HanjingLaura/hutong-moles/web/characters/kay.png

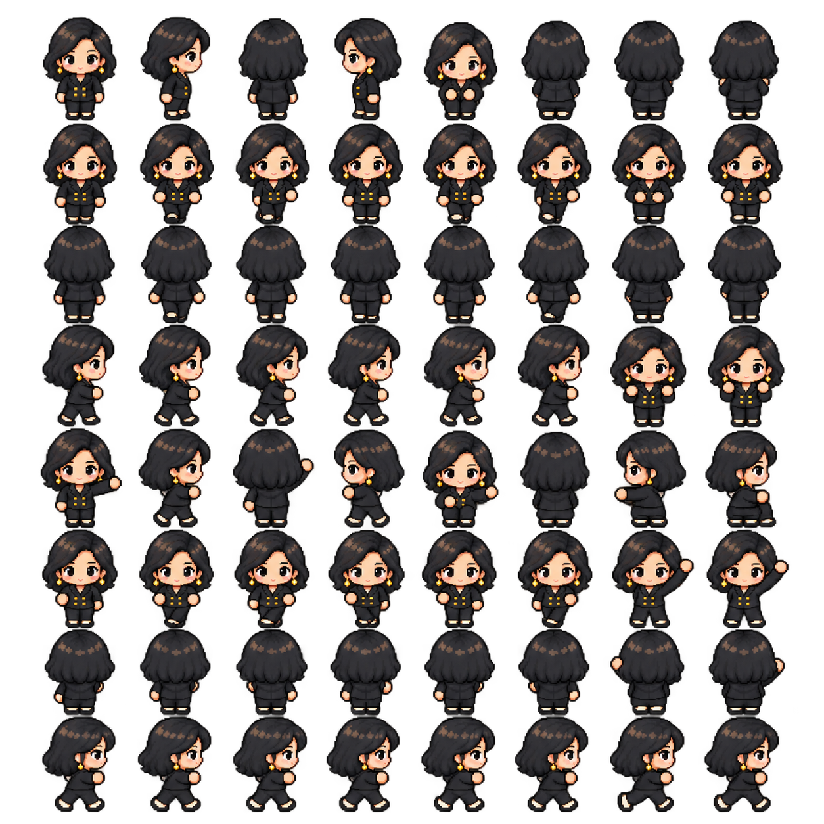
web/characters/kay.png
