HanjingLaura/hutong-moles/web/characters/cora.png

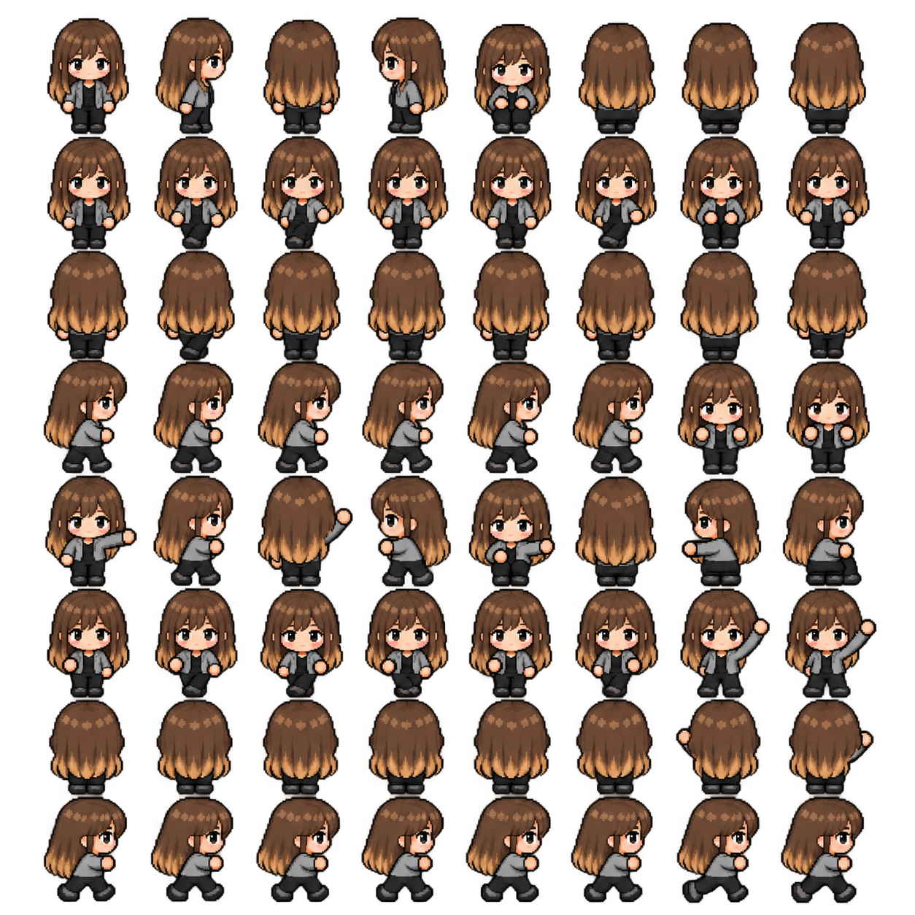
web/characters/cora.png
