HanjingLaura/hutong-moles/LEARNING.md

# Hutong Moles 学习总结

2026-10-04 完成。一块 Arduino Uno、6 颗 LED、6 个按键，加一个网页，做成了实体打地鼠：网页决定哪只地鼠冒头，对应的灯亮，按下对应按键就算打中。

## 这个项目做了什么

- **硬件**：Uno 只干两件事：按网页的命令点灯，按键被按下时报告给网页。
- **软件**：游戏规则（出地鼠、计时、计分）全在网页里，通过 USB 串口（Web Serial）和 Uno 通信。
- **分工的好处**：改玩法只要改网页，不用重新烧录；Uno 的代码很短，出问题容易排查。

## 学到的硬件知识

### 1. 面包板内部怎么连的

- 中间区域每一条 **5 孔竖排是连通的**，中间凹槽把上下两半隔开。
- 两边的长条是电源轨，红色（+）和蓝色（−）各自整条连通；有些长面包板的电源轨在中间断开。
- 规律：**插在同一条竖排里的脚，等于用导线连在一起了。** 这次两个坑都是因为这一条。

### 2. LED 电路

- 接法：引脚 → 220Ω 电阻 → 长脚（正极），短脚（负极）→ GND。
- 电阻用来限流，不加的话 LED 和引脚都可能烧坏。
- LED 有方向，接反就不亮（不会坏，翻过来就好）。

### 3. 6×6 轻触按键

- 四只脚两两常通，按下时两对才连起来。
- **取对角的两只脚** 最保险，无论怎么转都是按下才通。
- 按键横跨中间凹槽插，两边的脚就落在不同的竖排里。
- 要压到底，没插紧会接触不良。

### 4. 内部上拉（INPUT_PULLUP）

- 引脚设成 `INPUT_PULLUP` 后，芯片内部有一个电阻把它拉到高电平，不按读 HIGH（模拟读数约 1023）。
- 按下时按键把引脚接到 GND，读到 LOW（约 0）。
- 所以按键 **不需要外接电阻**，只要两根线：一根到 A 口，一根到地。地线可以共用同一条蓝色地轨。

### 5. A0–A5 也能当普通数字口用

- 模拟口可以 `digitalRead`，也可以 `analogRead` 看 0–1023 的具体数值。排查时用数值比只看 HIGH/LOW 信息多得多。

### 6. 去抖动

- 按键按下的一瞬间会抖动好几次。固件要求状态稳定 20 毫秒才算一次按下，避免一次按键被算成好几次。

## 排查过程（最值钱的部分）

| 现象 | 原因 | 怎么发现的 | 改法 |
| --- | --- | --- | --- |
| D2 的灯不亮 | 按键的地线插进了灯那一排，把 D2 的输出直接短到了地 | 逐根线对照，看哪条竖排里有不该有的线 | 地线挪回蓝色地轨 |
| 按键一接上，旁边的灯就灭 | 按键一只脚和 LED 长脚在同一条竖排 | 同上，检查竖排 | 按键挪到空白位置，横跨凹槽插 |
| 6 个按键不按也读到约 19（应该是 1023） | 线全接在常通的那对脚上，等于一直按着 | 串口打印 A0–A5 的模拟读数 | 改成对角接，读数恢复 1023 |
| 要很用力才按得通 | 按键没插到底 | 手感 + 读数时有时无 | 把按键压到贴住板面 |

### 学到的排查方法

1. **先测量，再猜。** 让板子把读数打印到串口，19 和 1023 一眼就能看出“一直按着”。
2. **一次只看一路。** 先确认一颗灯、一个按键对了，再复制到 6 路。
3. **按竖排检查。** 面包板上大部分问题，都是两样不该连的东西落在了同一条竖排里。
4. **写一个自检模式。** 固件里的 `TEST` 命令让灯跑一圈、按键报编号，不开游戏也能确认接线。

## 学到的软件 / 通信知识

- **串口协议**：一行一条文本命令，用换行结尾。网页发 `ON:n` / `OFF:n` / `ALL:0|1` / `PING` / `TEST`，Uno 回 `READY` / `HIT:n` / `PONG`。文本协议的好处是能直接用串口监视器手动调试。
- **打开串口会让 Uno 复位**：所以 Uno 开机跑完流水灯再发 `READY`，网页等到 `READY` 才开始发命令（最多等 4 秒）。
- **同一个串口一次只能被一个程序占用**：串口监视器开着，网页就连不上。
- **Web Serial**：Chrome 和 Edge 网页可以直接访问 USB 串口，不用装驱动以外的软件。
- **arduino-cli**：不打开 IDE 也能命令行编译和烧录。

## 下次可以试的升级

- 加一个蜂鸣器，打中时响一声（练 `tone()` 和 PWM）。
- 用 ESP32 换掉 Uno，走蓝牙或 Wi-Fi，就不用一直插 USB 线。
- 做一个外壳，把按键做成大圆按钮（街机按钮，接法和 6×6 按键一样，两根线）。
- 打板：把面包板接线画成 PCB，在嘉立创做一块，告别松动的杜邦线。
