HanjingLaura/hutong-moles/docs/screenshots/desktop-hit.png

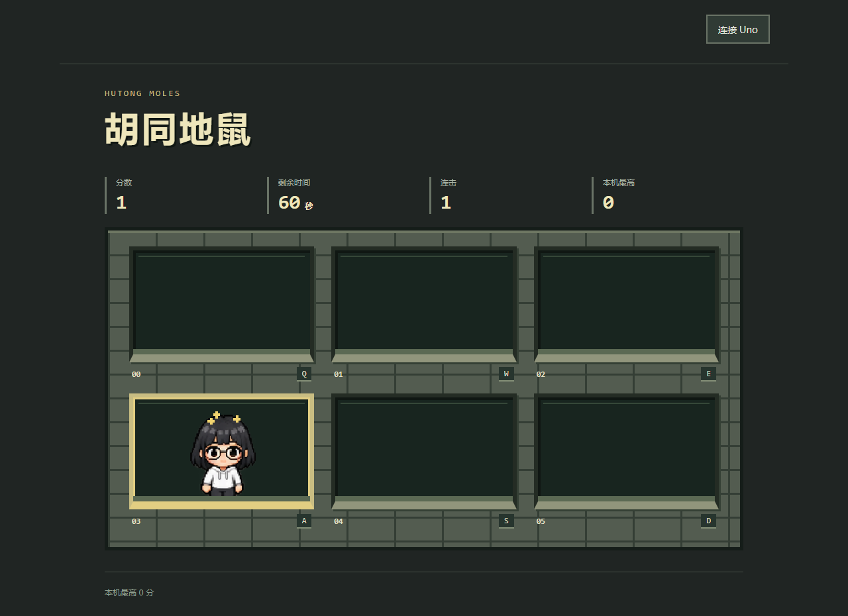
docs/screenshots/desktop-hit.png
