HanjingLaura/hutong-moles/docs/screenshots/desktop-selection.png

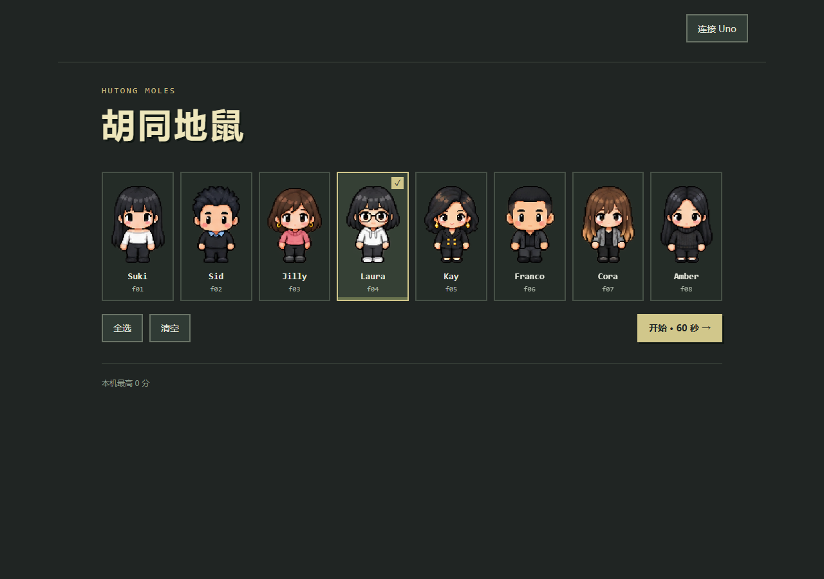
docs/screenshots/desktop-selection.png
