HanjingLaura/hutong-moles/docs/screenshots/mobile-hit.png

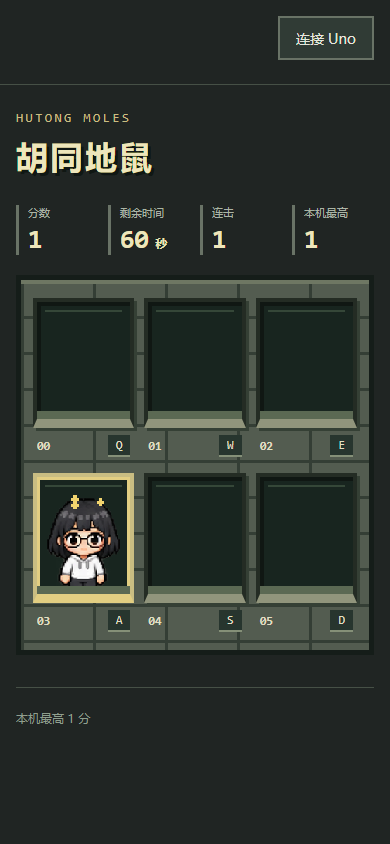
docs/screenshots/mobile-hit.png
