HanjingLaura/hutong-moles/docs/screenshots/mobile-selection.png

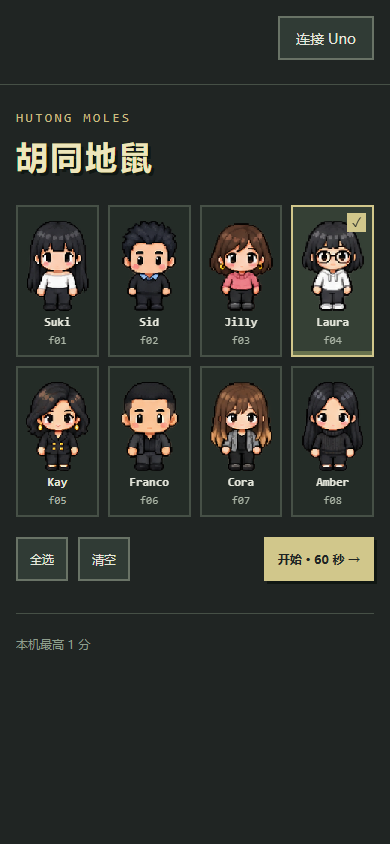
docs/screenshots/mobile-selection.png
