HanjingLaura/hutong-moles/web/characters/amber.png

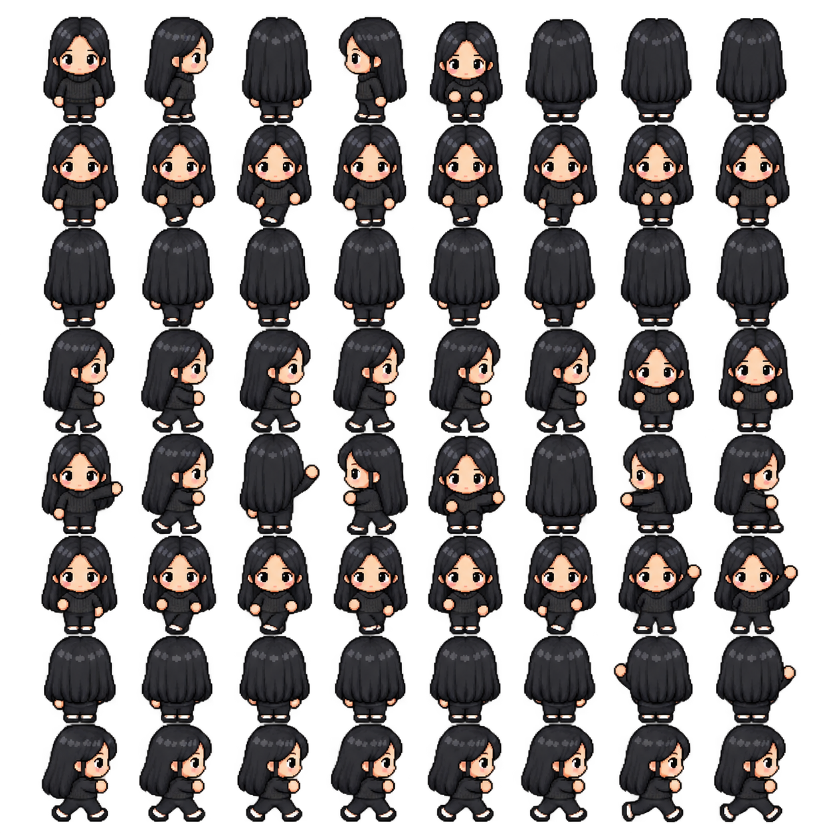
web/characters/amber.png
