HanjingLaura/hutong-moles/web/characters/franco.png

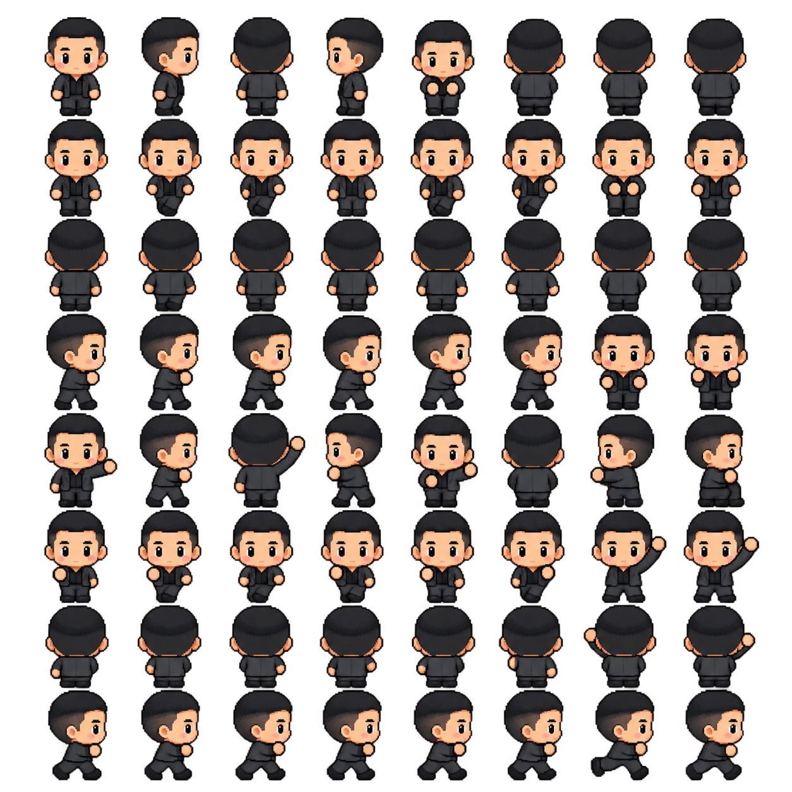
web/characters/franco.png
