HanjingLaura/hutong-moles/web/characters/jilly.png

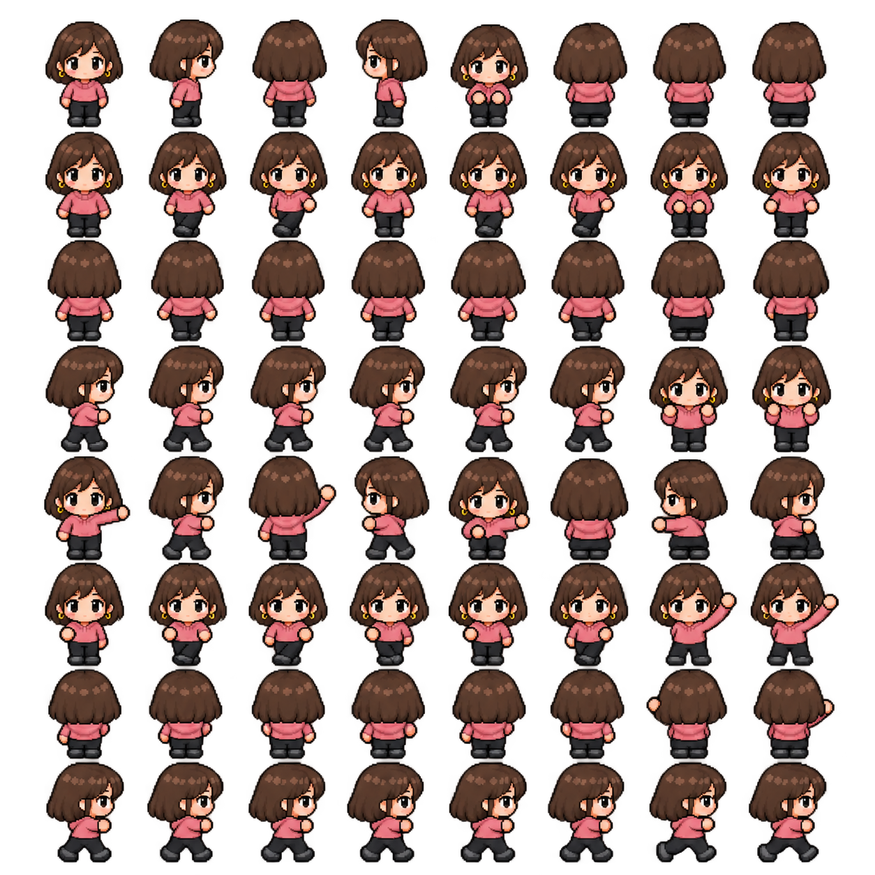
web/characters/jilly.png
