HanjingLaura/hutong-moles/web/characters/laura.png

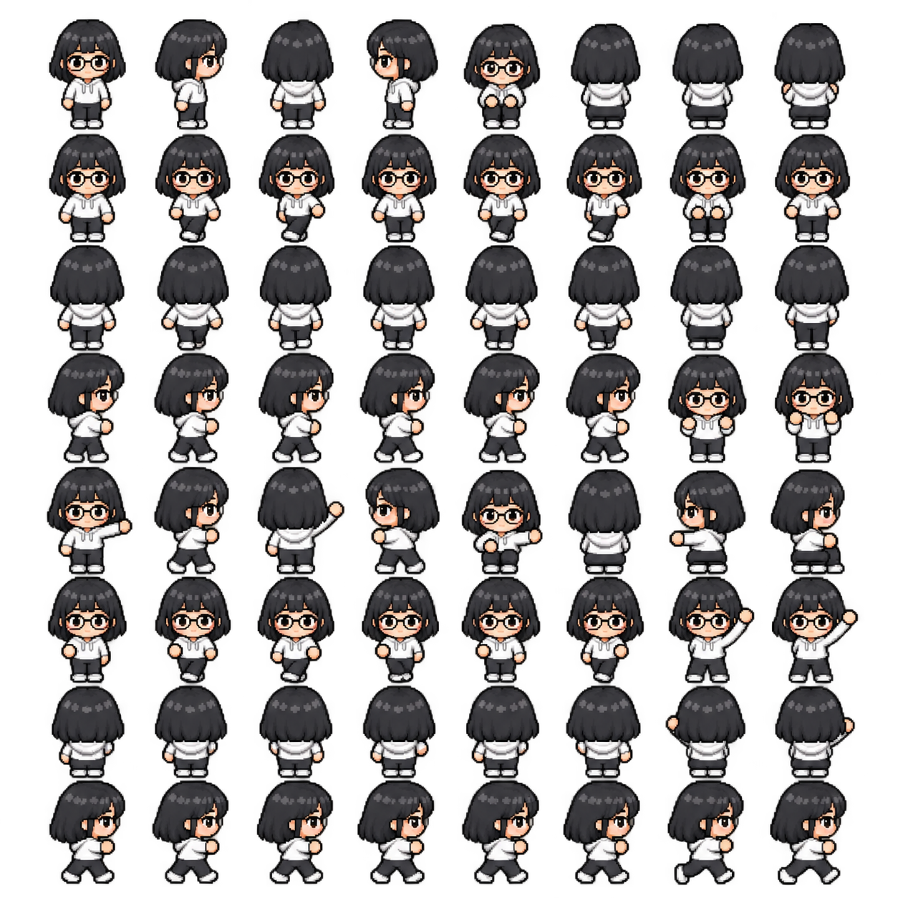
web/characters/laura.png
