HanjingLaura/hutong-moles/web/characters/sid.png

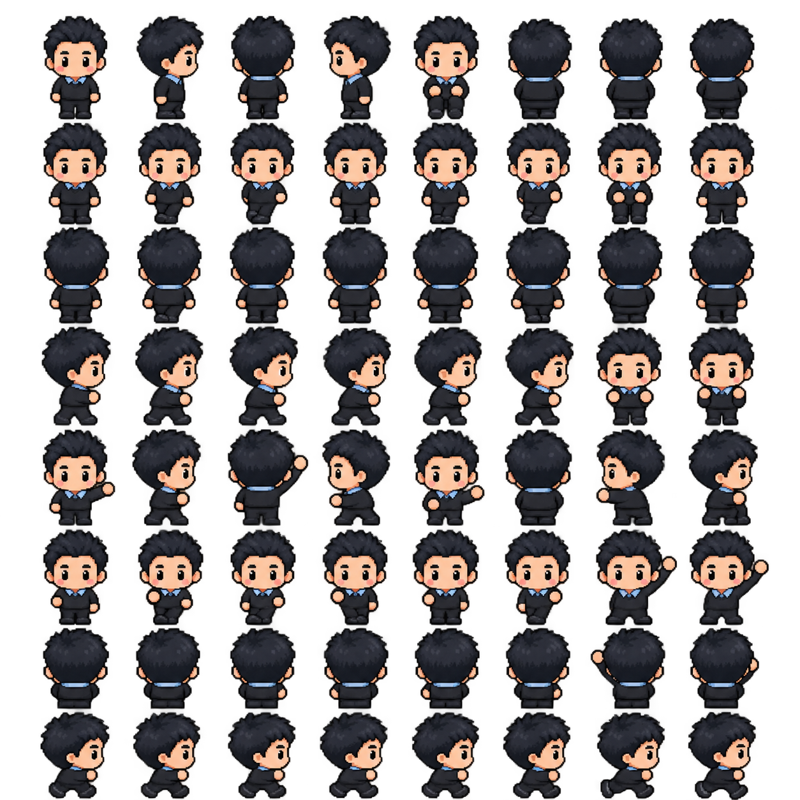
web/characters/sid.png
