HanjingLaura/hutong-moles/web/characters/suki.png

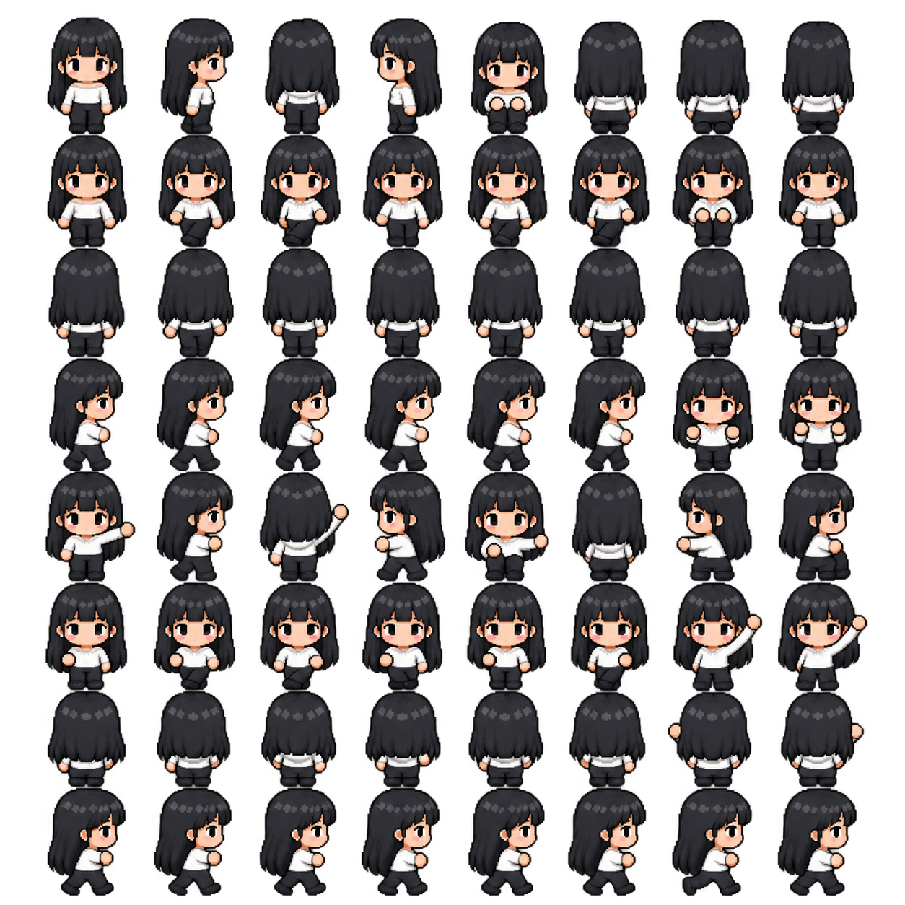
web/characters/suki.png
