HanjingLaura/hutong-moles/WIRING.md

# Hutong Moles 接线说明

拆掉面包板以后，照这份说明就能把胡同地鼠原样接回来。引脚以 `firmware/hutong_moles/hutong_moles.ino` 为准，这份说明和实测通过的接法一致（2026-10-04）。

## 需要的东西

- Arduino Uno（兼容板也行，本次用的是 CH340 串口芯片的版本）× 1，加 USB 线
- 6×6 轻触按键 × 6
- 5mm LED × 6，加 220Ω 电阻 × 6
- 面包板（本次是 60 列的）、杜邦线（建议黑线接 GND，其他颜色接信号）

## 第 0 步：地轨

1. Uno 的 `GND` 接到面包板的蓝色（−）电源轨。
2. 有些长面包板的电源轨在中间是断开的（轨道上的红蓝线中间有缺口就是）。如果灯和按键分布在两段，用一根跳线把左右两段蓝色轨连起来。
3. 这个项目只用 GND，不需要接 5V 或 3.3V：灯的电来自 D 口，按键用的是芯片内部上拉。

## 第 1 步：6 颗 LED

接法：D 口 → 220Ω 电阻 → LED 长脚（正极），LED 短脚（负极）→ 蓝色地轨。

| LED | 接到 | 对应地鼠洞 |
| --- | --- | --- |
| LED 0 | D2 | 洞 0 |
| LED 1 | D3 | 洞 1 |
| LED 2 | D4 | 洞 2 |
| LED 3 | D5 | 洞 3 |
| LED 4 | D6 | 洞 4 |
| LED 5 | D7 | 洞 5 |

## 第 2 步：6 个按键

每个按键**对角的两只脚**：左上脚接 A 口，右下脚接蓝色地轨。代码里用了内部上拉（`INPUT_PULLUP`），所以不用另外加电阻，按下时读到 LOW。

| 按键 | 接到 | 对应地鼠洞 |
| --- | --- | --- |
| 按键 0 | A0 | 洞 0 |
| 按键 1 | A1 | 洞 1 |
| 按键 2 | A2 | 洞 2 |
| 按键 3 | A3 | 洞 3 |
| 按键 4 | A4 | 洞 4 |
| 按键 5 | A5 | 洞 5 |

三条一定要守住（这次三个坑都踩过）：

1. **按键单独放在空的竖排上**，横跨中间凹槽插。它的脚不能和任何电阻、LED 脚、D 口线在同一条 5 孔竖排里，否则按键一接地，就把灯的正极也拉到地，灯就不亮。
2. **取对角的两只脚**。按键四只脚两两常通，同一侧靠得近的两只脚按下才通，正对着的两只一直是通的。对角那一对怎么转都一定是“按下才通”。接错的表现是不按也读到 LOW，等于一直按着。
3. **按键要压到底**，贴住板面。没插到底的话要使劲按才有反应。

## 第 3 步：检查和烧录

通电前对一遍：

- [ ] 6 颗 LED 长脚都朝电阻那一侧，短脚都在蓝色地轨上
- [ ] 每个按键只连两根线：A 口线和地线，而且不在同一竖排
- [ ] 按键所在的竖排里没有电阻或 LED 的脚
- [ ] 如果地轨中间断开，两段之间补了跳线

然后：

1. 烧录 `firmware/hutong_moles/hutong_moles.ino`（板子选 Arduino Uno，波特率 115200）。烧完板子重启，6 颗灯依次跑一圈，串口会打出 `READY`。
2. 自检：打开串口监视器（115200，换行符选 LF），输入 `TEST`，灯会跑一圈，然后逐个按键，应该看到 `键 n 按下`。测完**关掉串口监视器**，否则网页连不上。
3. 用电脑上的 Chrome 或 Edge 打开 [胡同地鼠网页](https://hanjing-laura.vercel.app/dishu/)，点连接按钮，选 CH340 那个串口。灯跑一圈后显示已连接，就可以玩了。
4. 玩的时候 USB 线要一直插着：游戏规则在网页里跑，Uno 只负责点灯、读按键，供电也来自这根线。

## 引脚总表

| 引脚 | 用途 |
| --- | --- |
| D2 / D3 / D4 / D5 / D6 / D7 | LED 0–5 |
| A0 / A1 / A2 / A3 / A4 / A5 | 按键 0–5 |
| GND | 蓝色地轨（LED 短脚和按键共用） |
| USB | 供电 + 串口（115200） |

## 串口协议（网页 ↔ Uno）

| 方向 | 消息 | 意思 |
| --- | --- | --- |
| Uno → 网页 | `READY` | 开机自检完成，可以发命令 |
| Uno → 网页 | `HIT:n` | 按键 n 被按下（0–5） |
| Uno → 网页 | `PONG` | 回应 `PING` |
| 网页 → Uno | `ON:n` / `OFF:n` | 点亮 / 熄灭 LED n |
| 网页 → Uno | `ALL:1` / `ALL:0` | 全亮 / 全灭 |
| 网页 → Uno | `PING` | 检查连接 |
| 网页 → Uno | `TEST` | 进入按键自检模式 |
