HanjingLaura/hutong-moles/docs/screenshots/desktop-result.png

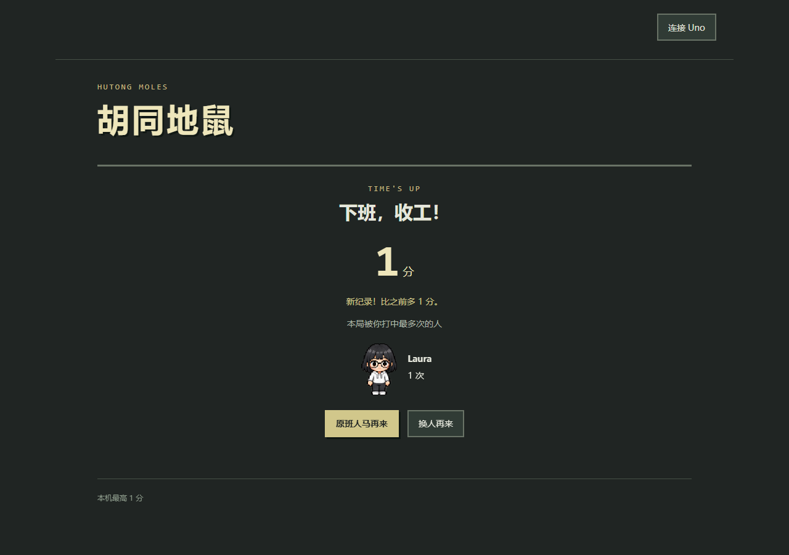
docs/screenshots/desktop-result.png
