HanjingLaura/hutong-moles/docs/screenshots/mobile-result.png

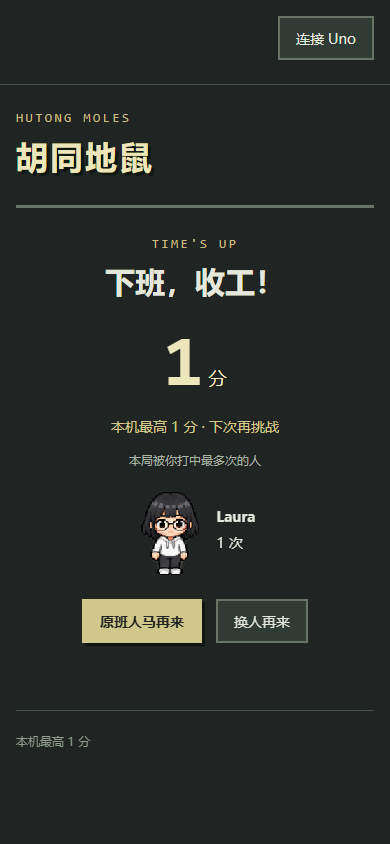
docs/screenshots/mobile-result.png
